stoatworks-labs/stoatworks-parts/bidi-microusb-guard/check_sections.png

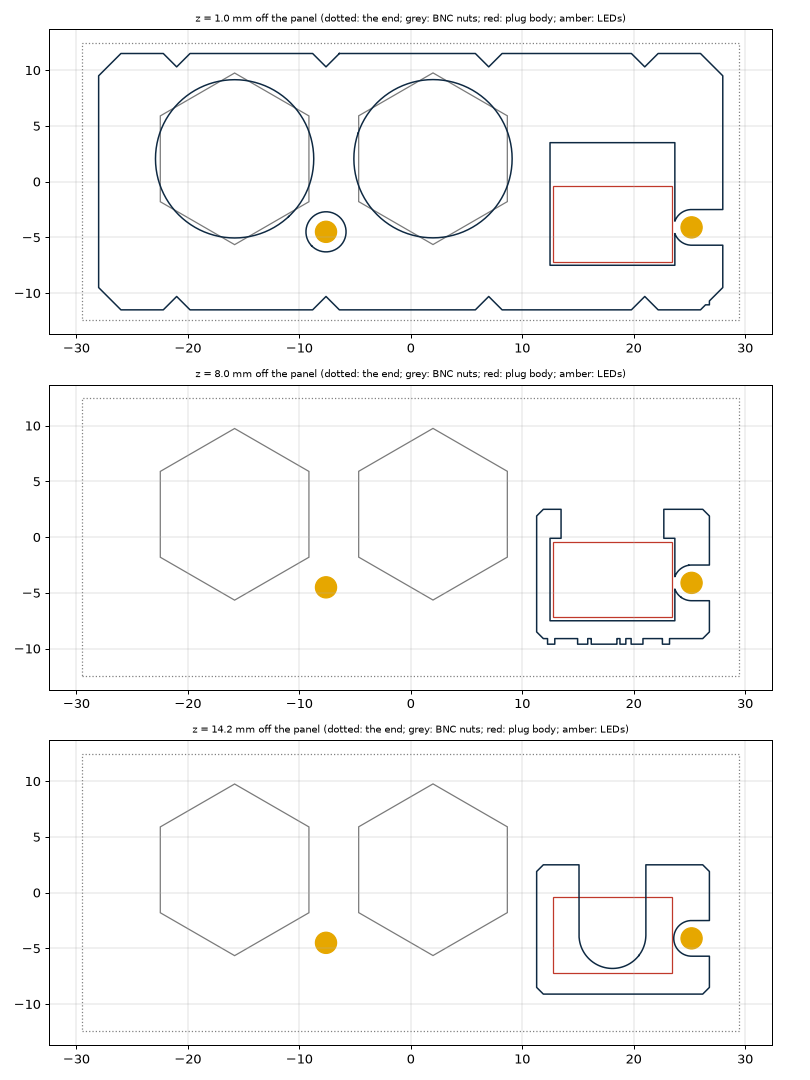
bidi-microusb-guard/check_sections.png
