stoatworks-labs/stoatworks-parts/bidi-usb-guard/check_sections.png

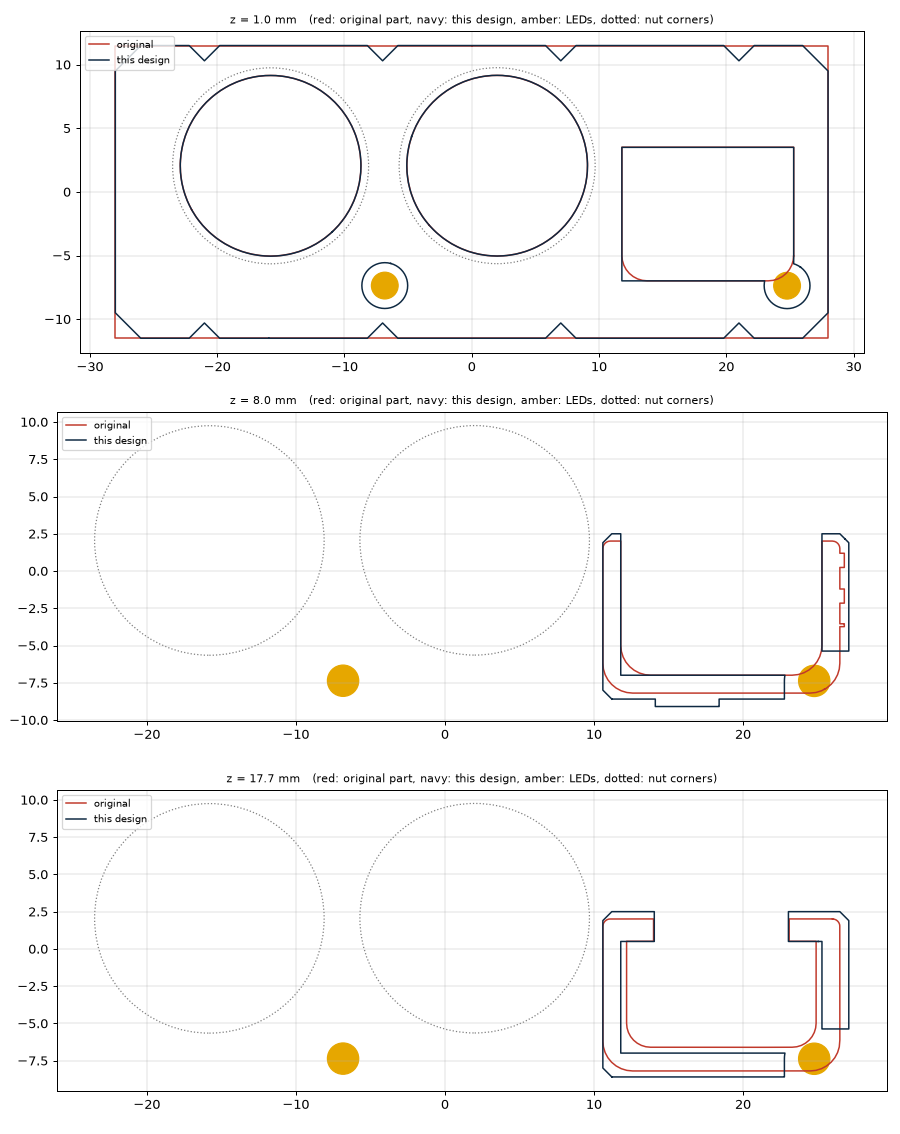
bidi-usb-guard/check_sections.png
