stoatworks-labs/stoatworks-parts/decimator-microusb-guard/check_sections.png

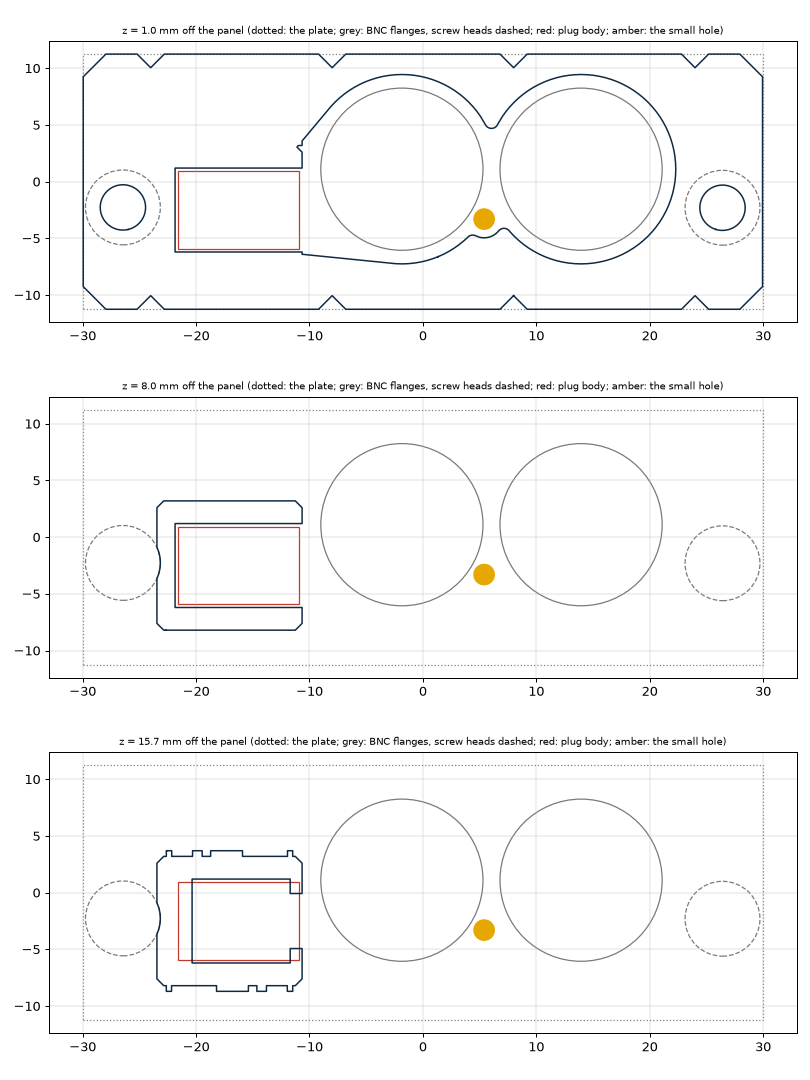
decimator-microusb-guard/check_sections.png
