stoatworks-labs/stoatworks-parts/decimator-usb-guard/check_sections.png

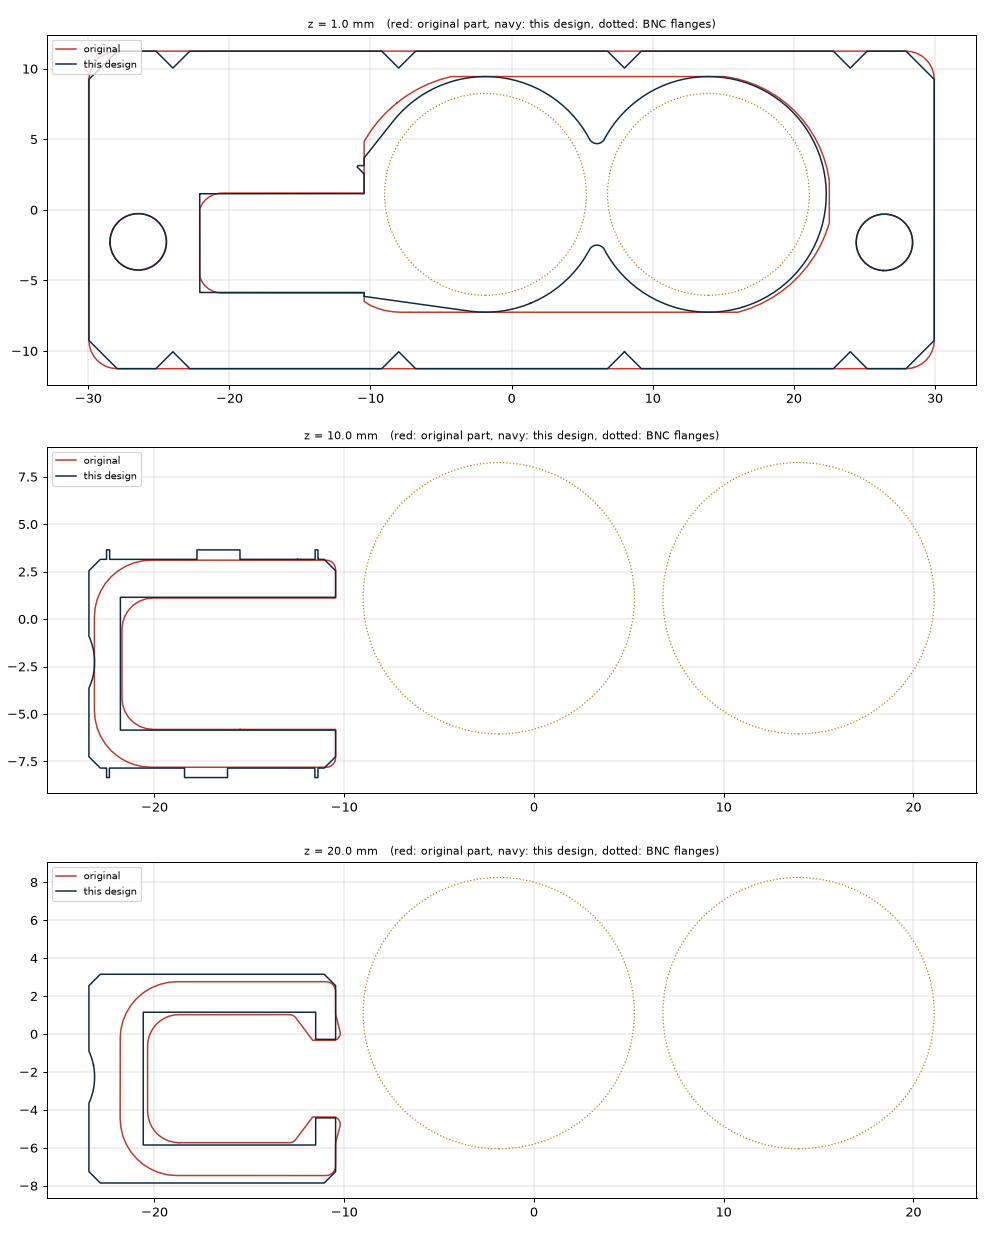
decimator-usb-guard/check_sections.png
