stoatworks-labs/stoatworks-parts/ip-mini-hdmi-clamp/check_sections.png

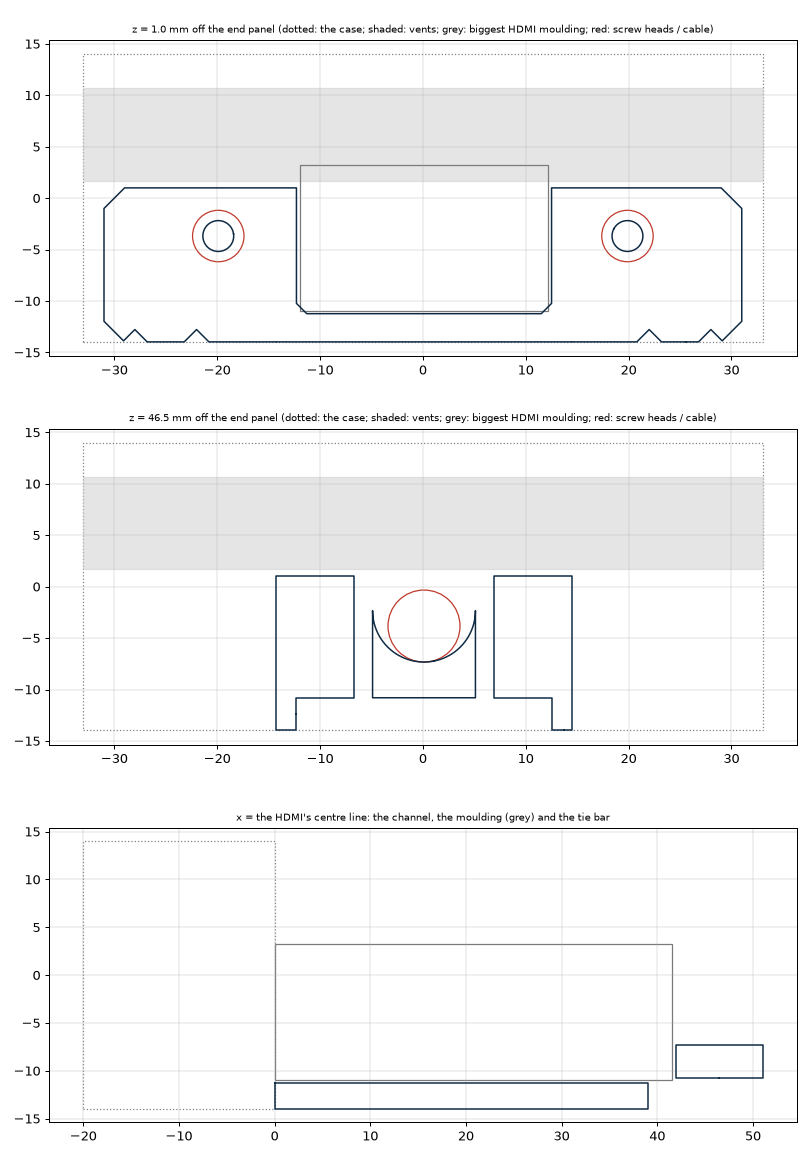
ip-mini-hdmi-clamp/check_sections.png
