stoatworks-labs/stoatworks-parts/micro-converter-microusb/check_sections.png

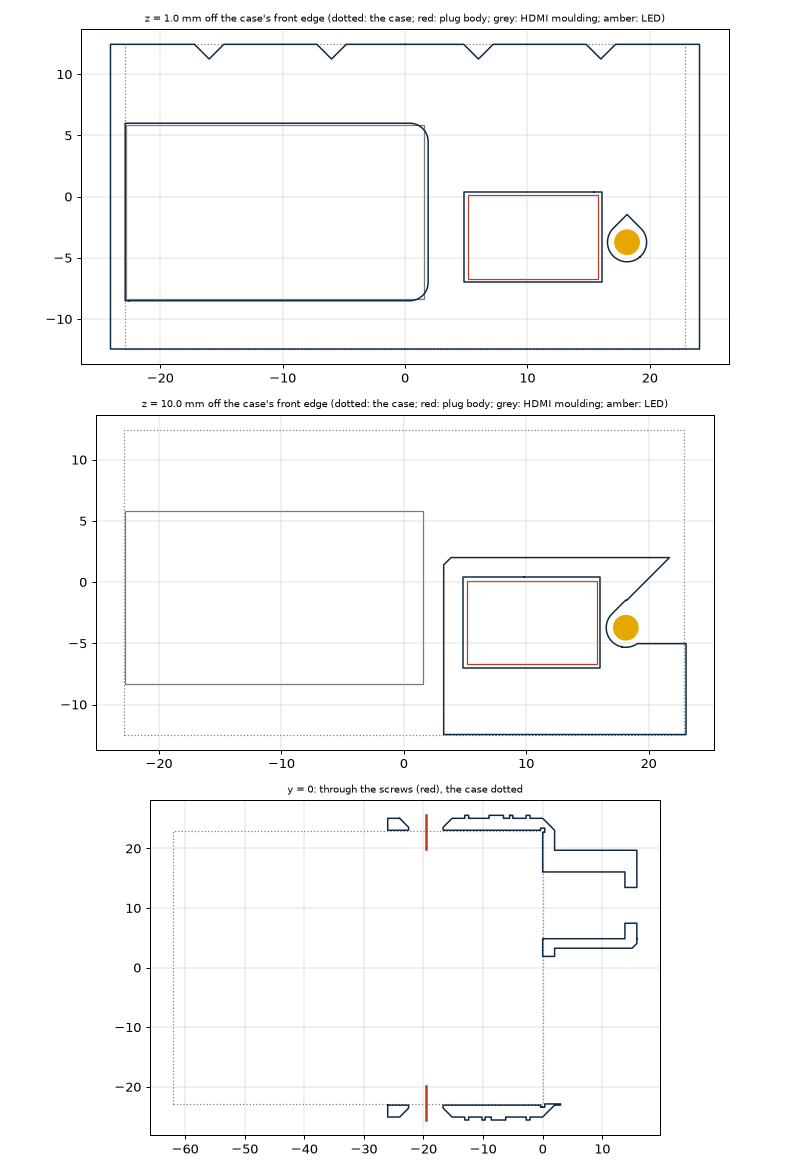
micro-converter-microusb/check_sections.png
