stoatworks-labs/stoatworks-parts/micro-converter-usb-guard/check_sections.png

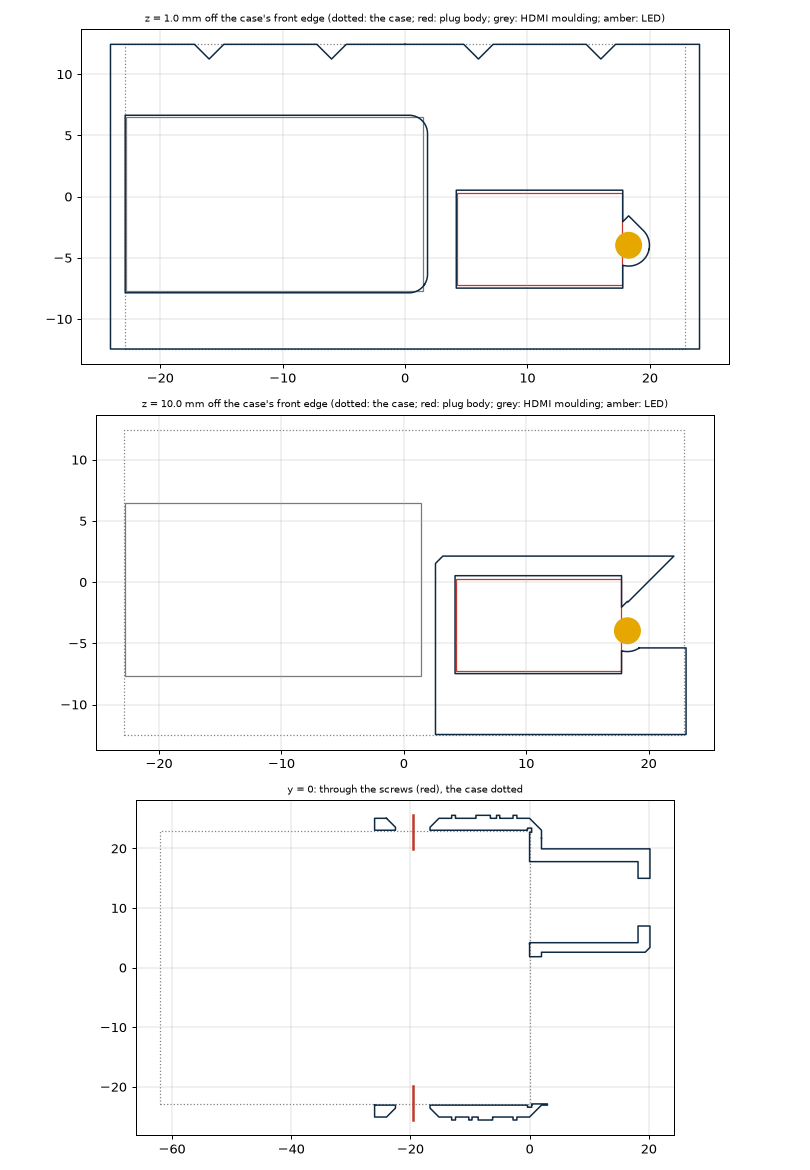
micro-converter-usb-guard/check_sections.png
