stoatworks-labs/stoatworks-parts/mini-converter-power-clamp/check_sections.png

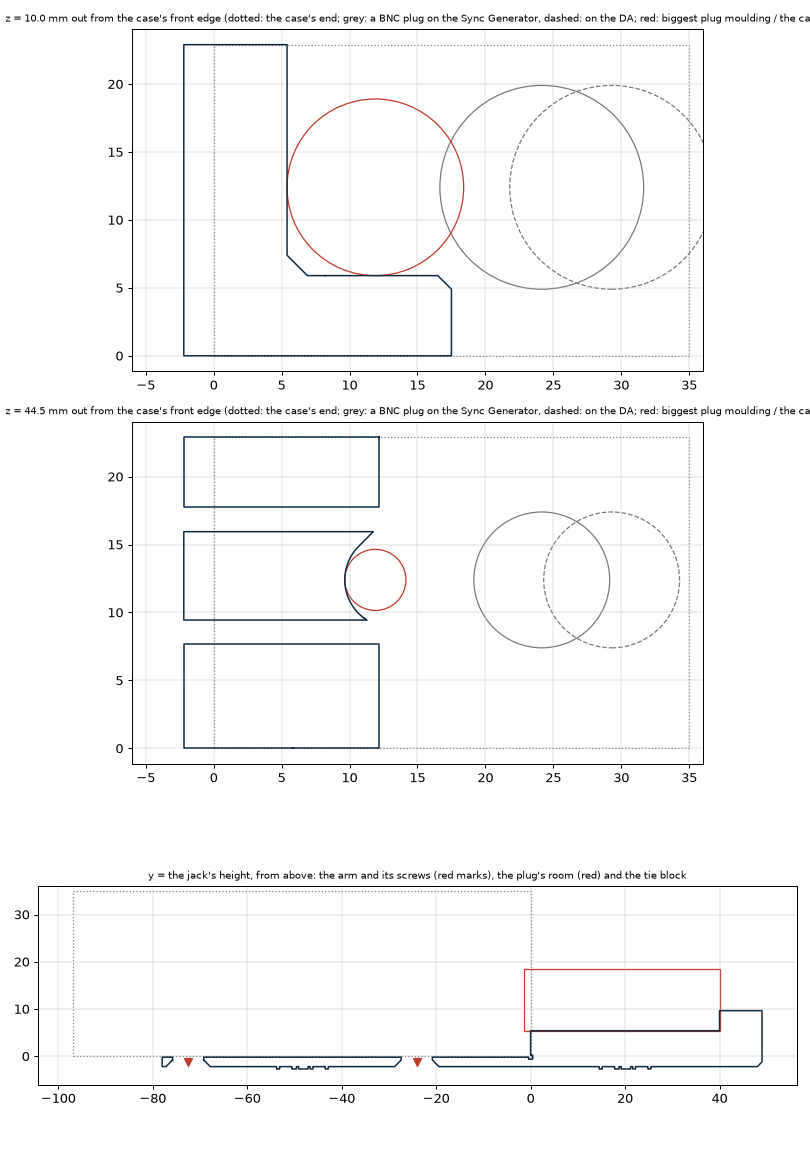
mini-converter-power-clamp/check_sections.png
