stoatworks-labs/stoatworks-parts/mini-converter-power-guard/check_sections.png

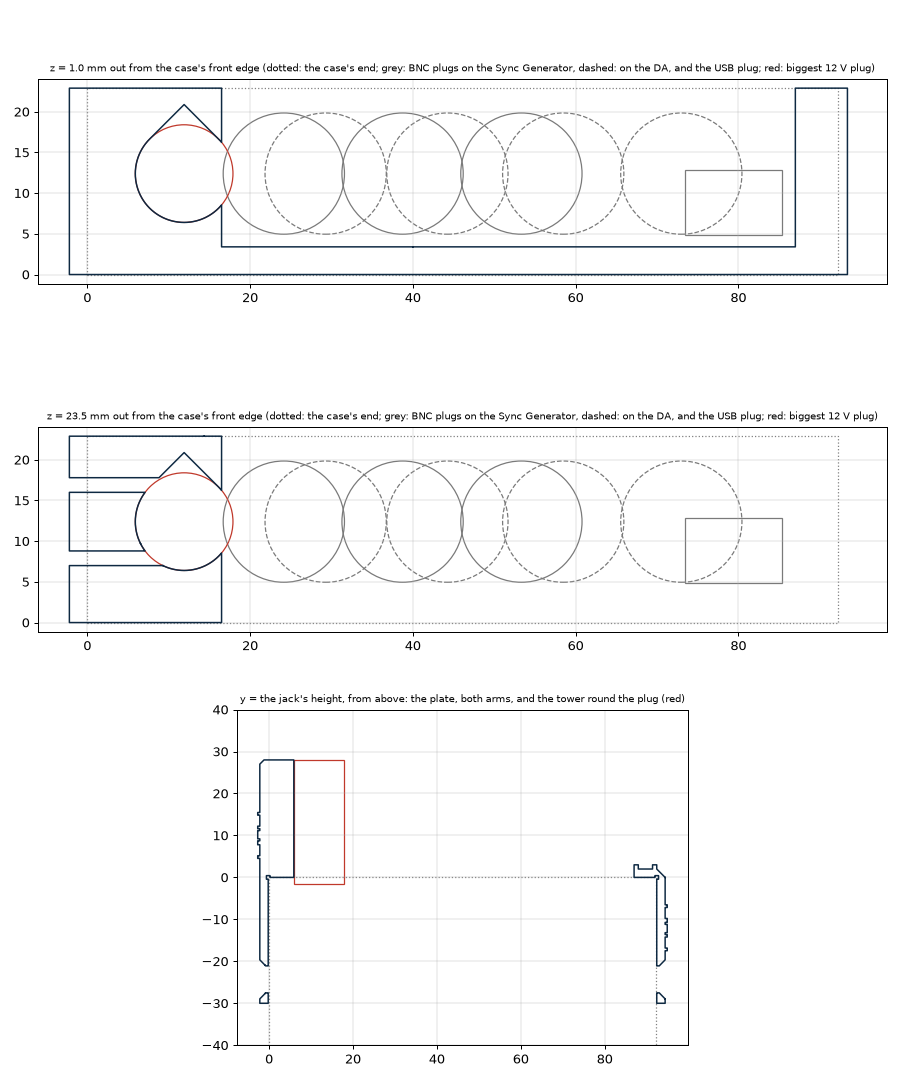
mini-converter-power-guard/check_sections.png
