stoatworks-labs/stoatworks-parts/bidi-microusb-guard/bidi_microusb_guard_v0.1-logo.stl

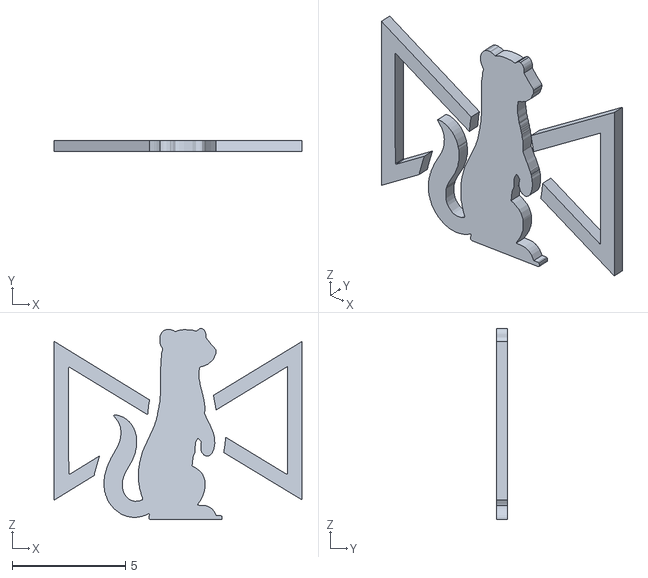
[picture p51: CAD file, 2026-10-25]
bidi-microusb-guard/bidi_microusb_guard_v0.1-logo.stl
10.9 x 0.5 x 8.44
