stoatworks-labs/stoatworks-parts/decimator-microusb-guard/decimator_microusb_guard_v0.1.stl

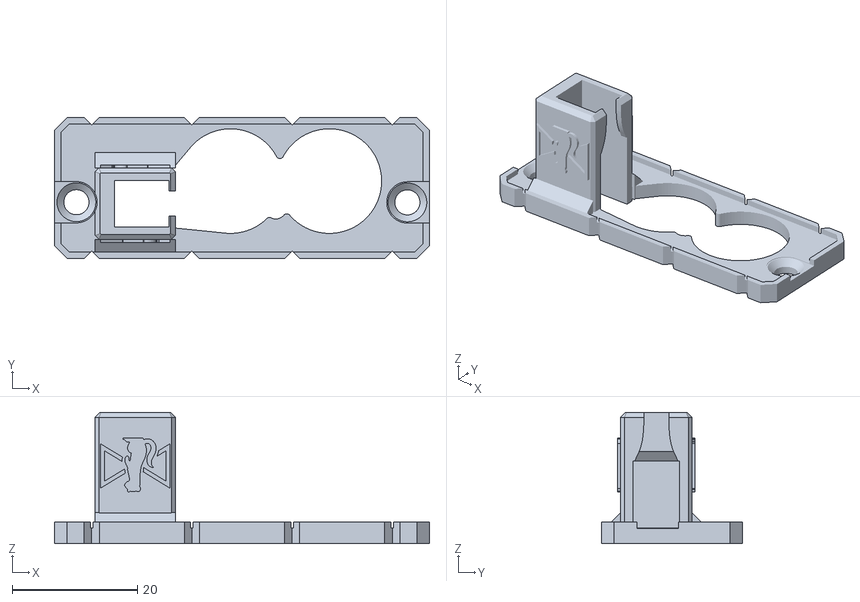
[picture p52: CAD file, 2026-10-25]
decimator-microusb-guard/decimator_microusb_guard_v0.1.stl
59.9 x 22.5 x 21.0
