stoatworks-labs/stoatworks-parts/ip-mini-hdmi-clamp/ip_mini_hdmi_clamp_v0.1.stl

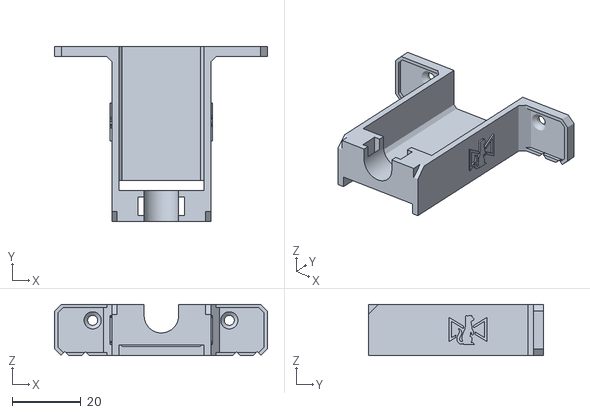
[picture p54: CAD file, 2026-10-25]
ip-mini-hdmi-clamp/ip_mini_hdmi_clamp_v0.1.stl
62.0 x 51.0 x 15.0
