stoatworks-labs/stoatworks-parts/micro-converter-microusb/micro_converter_microusb_guard_v0.1-body.stl

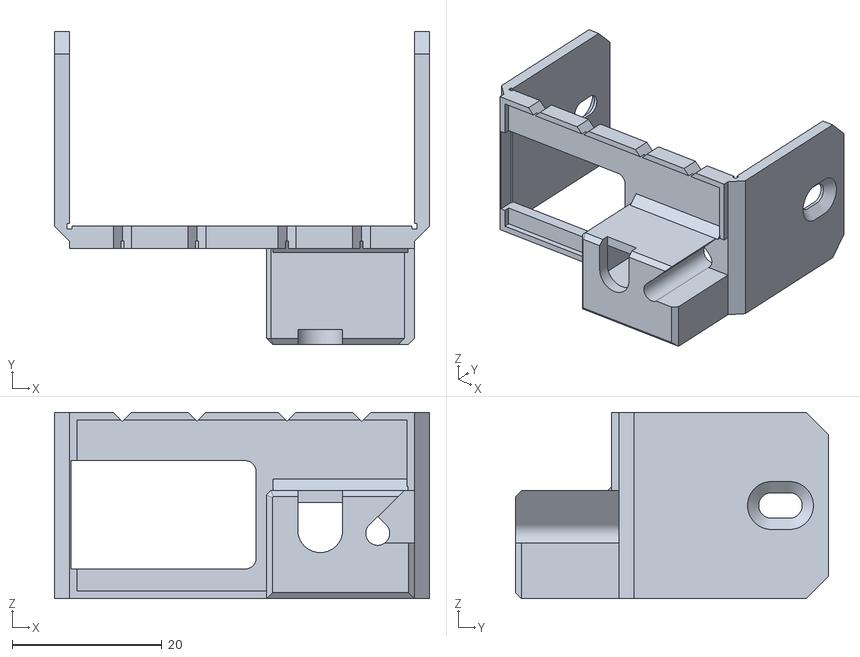
[picture p55: CAD file, 2026-10-25]
micro-converter-microusb/micro_converter_microusb_guard_v0.1-body.stl
50.1 x 41.8 x 24.9
