stoatworks-labs/stoatworks-parts/micro-converter-usb-guard/micro_converter_usb_guard_v0.1-body.stl

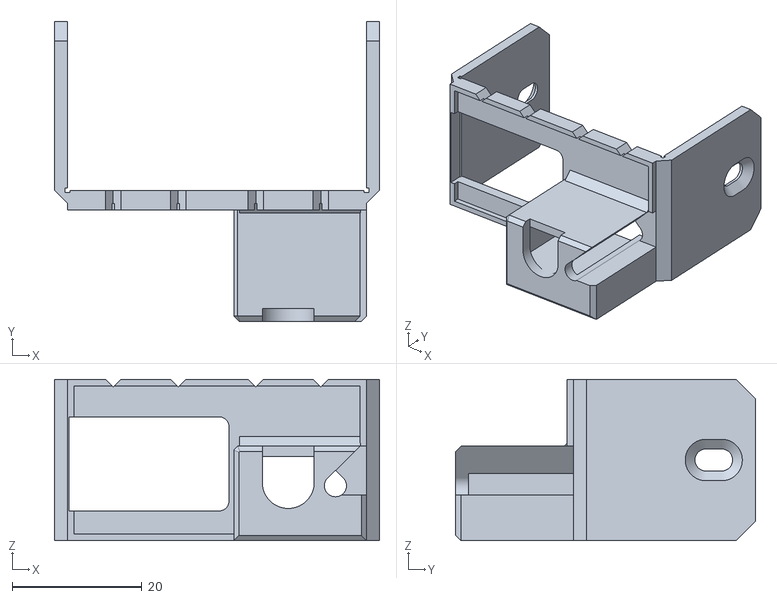
[picture p56: CAD file, 2026-10-25]
micro-converter-usb-guard/micro_converter_usb_guard_v0.1-body.stl
50.1 x 46.2 x 24.9
