stoatworks-labs/stoatworks-parts/mini-converter-power-clamp/mini_converter_power_clamp_v0.1-logo.stl

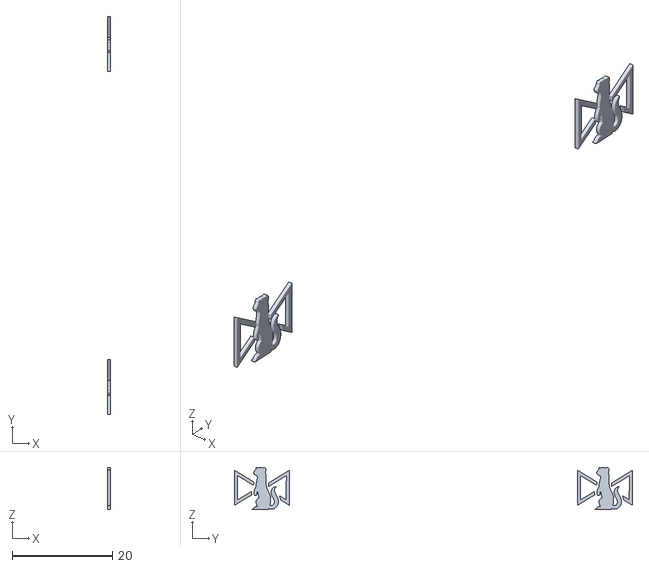
[picture p57: CAD file, 2026-10-25]
mini-converter-power-clamp/mini_converter_power_clamp_v0.1-logo.stl
0.5 x 79.2 x 8.44
