stoatworks-labs/stoatworks-parts/mini-converter-power-guard/mini_converter_power_guard_v0.1.stl

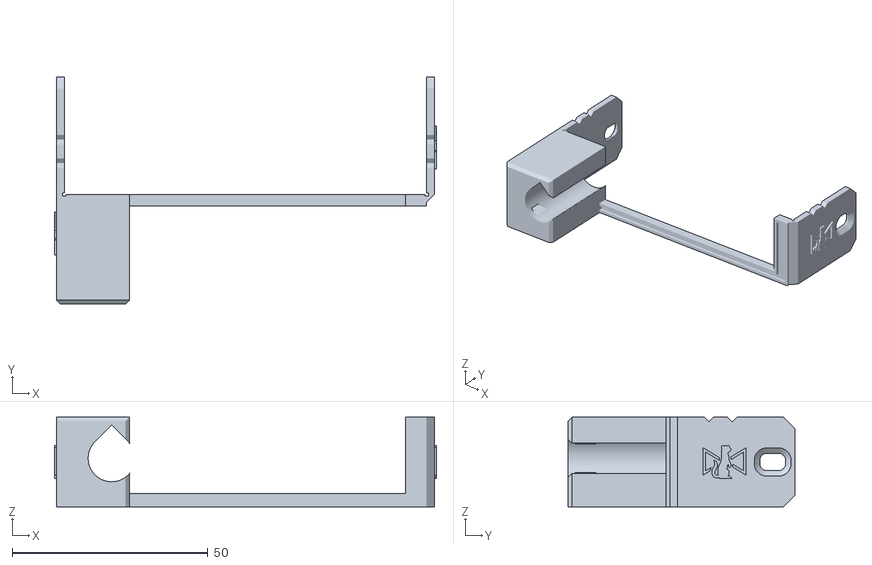
[picture p58: CAD file, 2026-10-25]
mini-converter-power-guard/mini_converter_power_guard_v0.1.stl
97.6 x 58.0 x 22.9
