stoatworks-labs/stoatworks-parts/bidi-usb-guard/bidi_usb_guard_v0.1-body.stl

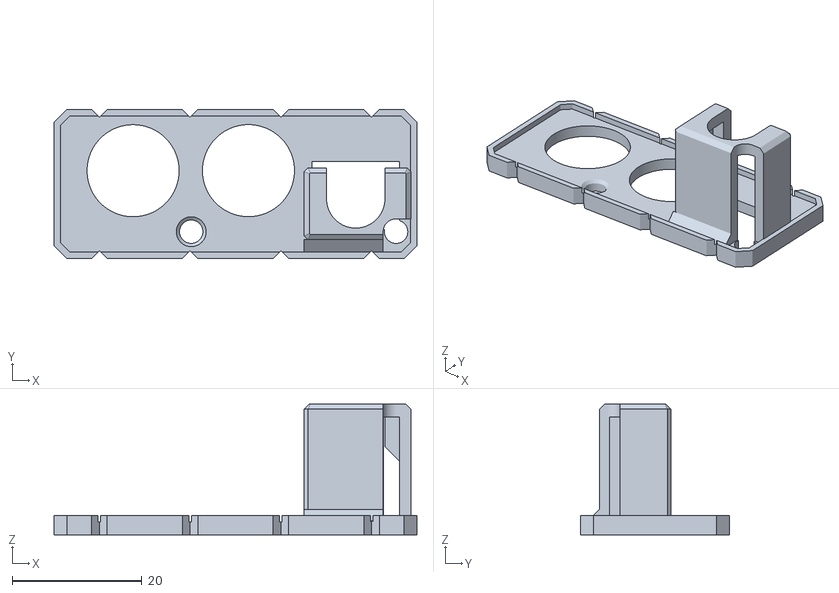
[picture p60: CAD file, 2026-10-25]
bidi-usb-guard/bidi_usb_guard_v0.1-body.stl
56.0 x 23.0 x 20.2
