stoatworks-labs/stoatworks-parts/decimator-microusb-guard/decimator_microusb_guard_v0.1-body.stl

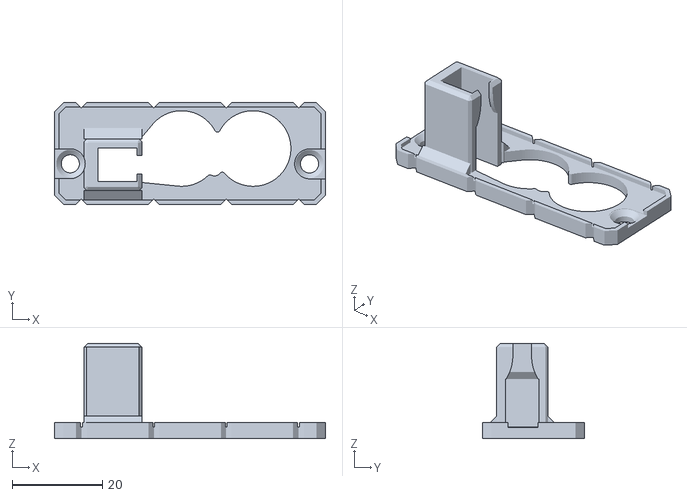
[picture p61: CAD file, 2026-10-25]
decimator-microusb-guard/decimator_microusb_guard_v0.1-body.stl
59.9 x 22.5 x 21.0
