stoatworks-labs/stoatworks-parts/decimator-usb-guard/decimator_usb_guard_v0.1-body.stl

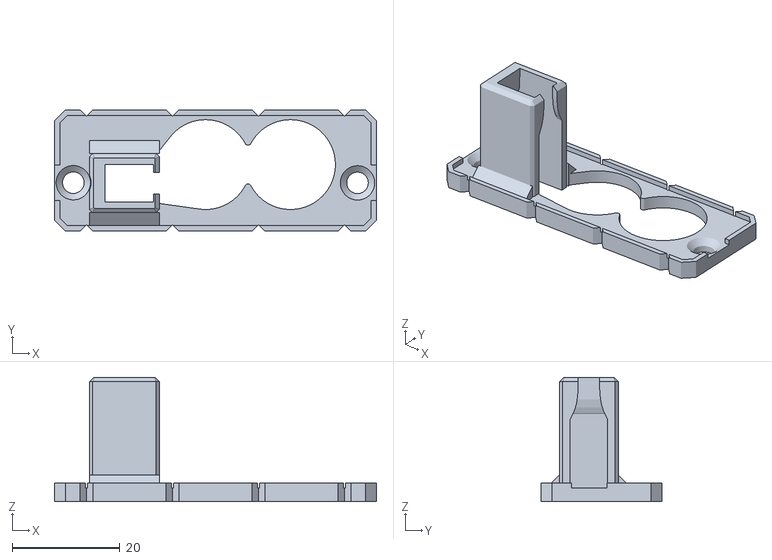
[picture p62: CAD file, 2026-10-25]
decimator-usb-guard/decimator_usb_guard_v0.1-body.stl
59.9 x 22.5 x 23.1
