stoatworks-labs/stoatworks-parts/ip-mini-hdmi-clamp/ip_mini_hdmi_clamp_v0.1-body.stl

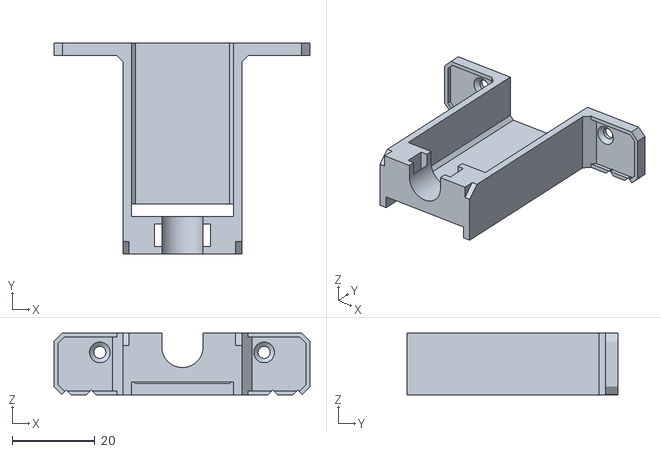
[picture p63: CAD file, 2026-10-25]
ip-mini-hdmi-clamp/ip_mini_hdmi_clamp_v0.1-body.stl
62.0 x 51.0 x 15.0
