stoatworks-labs/stoatworks-parts/micro-converter-microusb/micro_converter_microusb_guard_v0.1.stl

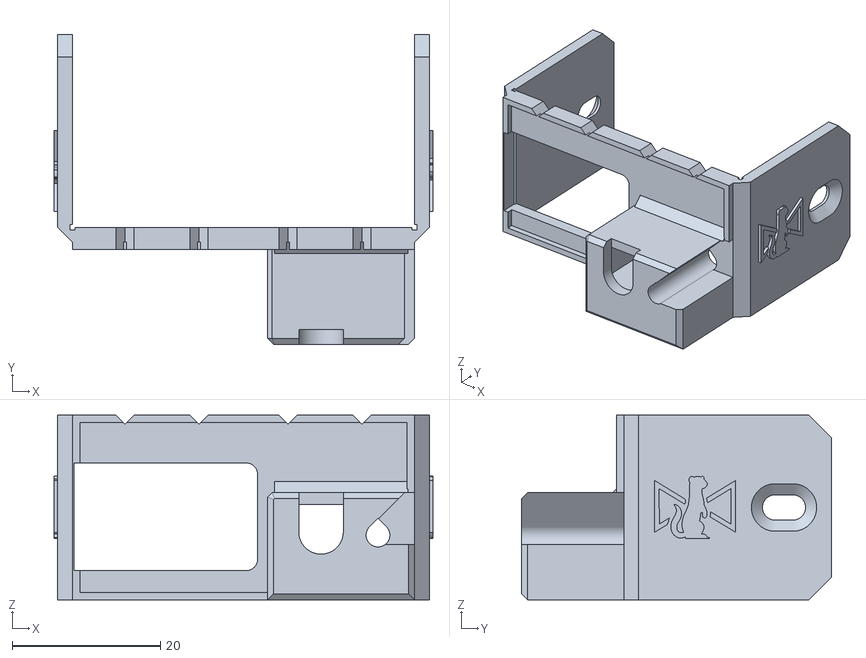
[picture p64: CAD file, 2026-10-25]
micro-converter-microusb/micro_converter_microusb_guard_v0.1.stl
51.1 x 41.8 x 24.9
