stoatworks-labs/stoatworks-parts/micro-converter-usb-guard/micro_converter_usb_guard_v0.1-logo.stl

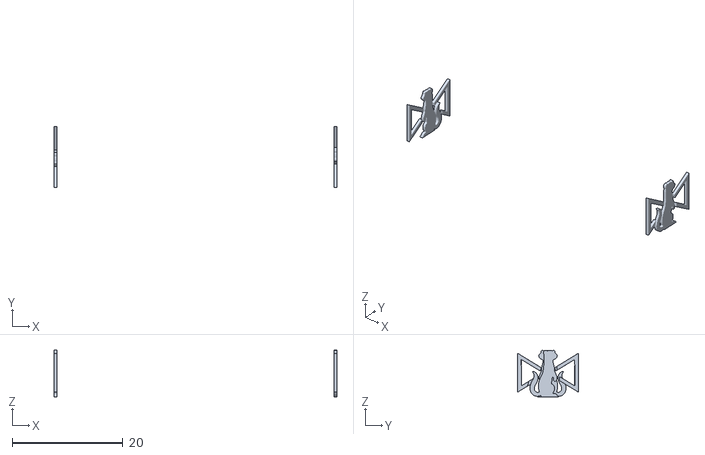
[picture p65: CAD file, 2026-10-25]
micro-converter-usb-guard/micro_converter_usb_guard_v0.1-logo.stl
51.1 x 10.9 x 8.44
