stoatworks-labs/stoatworks-parts/mini-converter-power-clamp/mini_converter_power_clamp_v0.1-body.stl

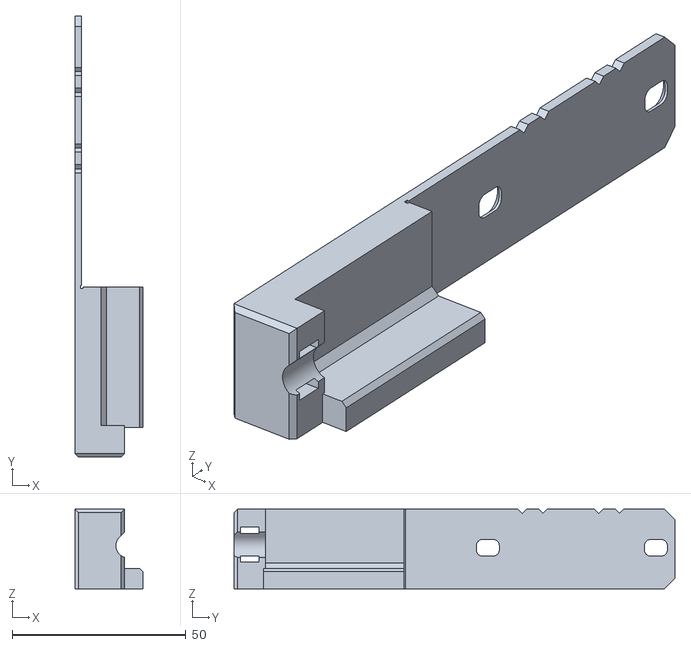
[picture p66: CAD file, 2026-10-25]
mini-converter-power-clamp/mini_converter_power_clamp_v0.1-body.stl
19.7 x 127.0 x 22.9
