stoatworks-labs/stoatworks-parts/mini-converter-power-guard/mini_converter_power_guard_v0.1-logo.stl

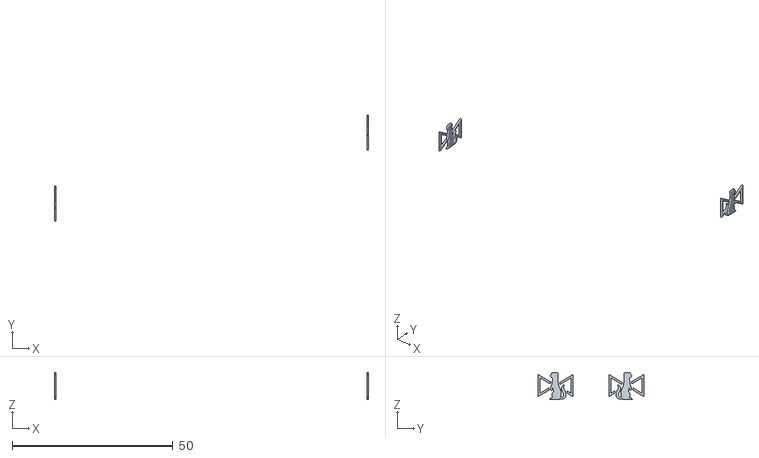
[picture p67: CAD file, 2026-10-25]
mini-converter-power-guard/mini_converter_power_guard_v0.1-logo.stl
97.6 x 32.9 x 8.44
