stoatworks-labs/stoatworks-parts/bidi-microusb-guard/bidi_microusb_guard_v0.1-body.stl

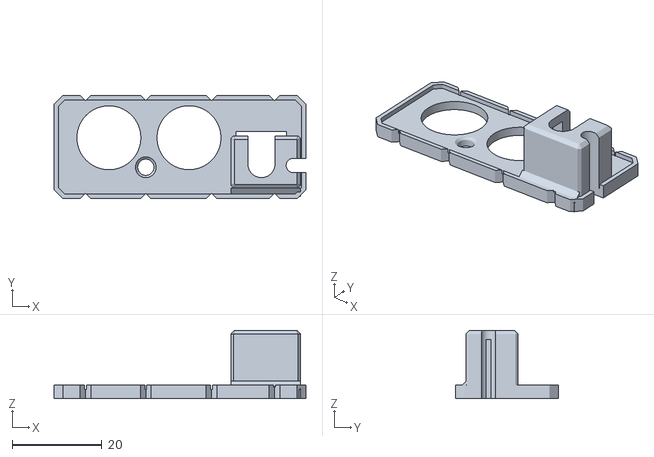
[picture p68: CAD file, 2026-10-25]
bidi-microusb-guard/bidi_microusb_guard_v0.1-body.stl
56.0 x 23.0 x 15.2
