stoatworks-labs/stoatworks-parts/decimator-microusb-guard/decimator_microusb_guard_v0.1-logo.stl

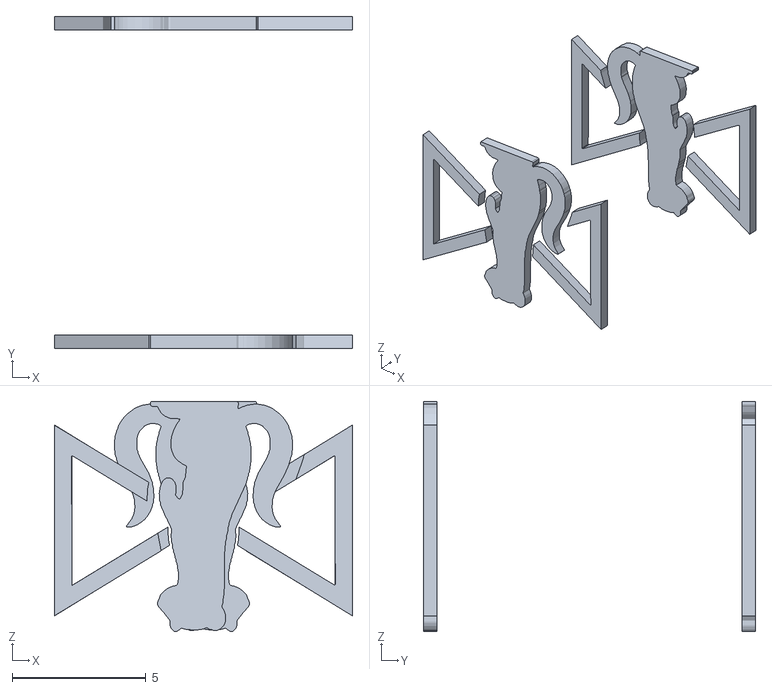
[picture p69: CAD file, 2026-10-25]
decimator-microusb-guard/decimator_microusb_guard_v0.1-logo.stl
11.1 x 12.4 x 8.59
