stoatworks-labs/stoatworks-parts/ip-mini-hdmi-clamp/ip_mini_hdmi_clamp_v0.1-logo.stl

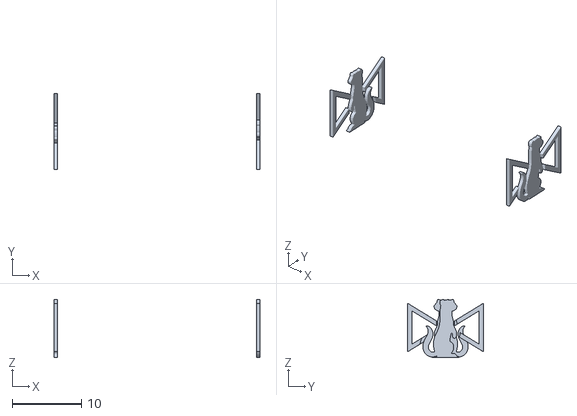
[picture p70: CAD file, 2026-10-25]
ip-mini-hdmi-clamp/ip_mini_hdmi_clamp_v0.1-logo.stl
29.8 x 10.9 x 8.44
