stoatworks-labs/stoatworks-parts/micro-converter-usb-guard/micro_converter_usb_guard_v0.1.stl

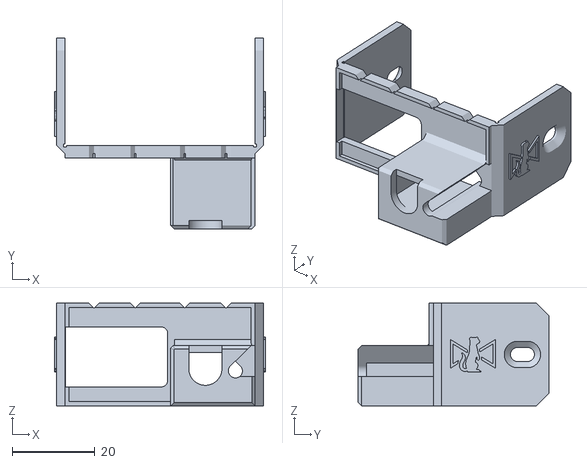
[picture p71: CAD file, 2026-10-25]
micro-converter-usb-guard/micro_converter_usb_guard_v0.1.stl
51.1 x 46.2 x 24.9
