stoatworks-labs/stoatworks-parts/mini-converter-power-clamp/mini_converter_power_clamp_v0.1.stl

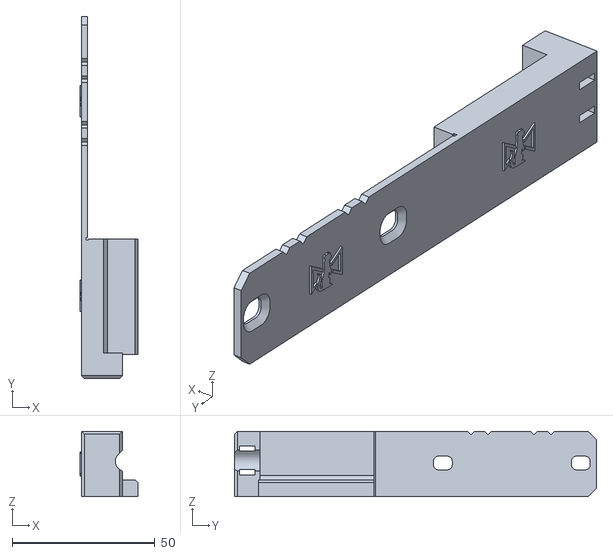
[picture p72: CAD file, 2026-10-25]
mini-converter-power-clamp/mini_converter_power_clamp_v0.1.stl
20.2 x 127.0 x 22.9
