stoatworks-labs/stoatworks-parts/bidi-microusb-guard/stoatworks_mark.scad

// Generated by stoatworks-remixes/logo.py. Do not edit.
// Stoatworks mark, solid, 10.94 x 8.44 mm, centred on the origin.
module stoatworks_mark() polygon(points=[[1.0692,4.2275],[1.1640,4.1434],[1.2142,4.0511],[1.2290,3.9857],[1.2301,3.8238],[1.4651,3.5213],[1.6465,3.3219],[1.6815,3.2540],[1.6670,3.1031],[1.6274,3.0331],[1.5821,2.8935],[1.5365,2.8345],[1.3234,2.6471],[1.1258,2.5612],[1.0247,2.5436],[0.9576,2.5065],[0.9194,2.3050],[0.9208,2.0477],[0.9597,1.8741],[0.9632,1.7737],[1.0028,1.6592],[1.0060,1.5892],[1.0452,1.5044],[1.0625,1.3906],[1.0876,1.3488],[1.1039,1.2244],[1.1300,1.1774],[1.1463,1.0130],[1.1718,0.9395],[1.1877,0.7285],[1.1749,0.4599],[1.3446,0.0912],[1.3973,0.0081],[1.5012,-0.2485],[1.5259,-0.2778],[1.5429,-0.3609],[1.5676,-0.3885],[1.5846,-0.5139],[1.6108,-0.5769],[1.6249,-0.8469],[1.5825,-1.1078],[1.5076,-1.2707],[1.4528,-1.3400],[1.3944,-1.3838],[1.3329,-1.4128],[1.2502,-1.4118],[1.1449,-1.3619],[1.0495,-1.2527],[1.0042,-1.1099],[1.0056,-0.9010],[1.0300,-0.7826],[0.9484,-0.6741],[0.8992,-0.6387],[0.8614,-0.6444],[0.7798,-0.7967],[0.7653,-0.8593],[0.7483,-1.2198],[0.7352,-1.2955],[0.7094,-1.3209],[0.6656,-1.4365],[0.6221,-1.8458],[0.7617,-1.9144],[0.9975,-2.0933],[1.0873,-2.2148],[1.1714,-2.4230],[1.1859,-2.5019],[1.1873,-2.8069],[1.1725,-2.9317],[1.0862,-3.1770],[0.9879,-3.3718],[0.8784,-3.5280],[0.8642,-3.5754],[1.2198,-3.5923],[1.3944,-3.6637],[1.4924,-3.7348],[1.5793,-3.8246],[1.6889,-4.0296],[1.8854,-4.0313],[1.9268,-4.0540],[1.9501,-4.0964],[1.9512,-4.1784],[1.9162,-4.2134],[-1.2170,-4.2105],[-1.2842,-4.1787],[-1.2856,-4.0964],[-1.2584,-4.0045],[-1.2598,-3.9681],[-1.2806,-3.9433],[-1.4471,-4.0274],[-1.4938,-4.0317],[-1.5786,-4.0709],[-1.8504,-4.1140],[-1.9992,-4.1126],[-2.2530,-4.0709],[-2.5075,-3.9719],[-2.7963,-3.7567],[-2.9607,-3.5771],[-3.0490,-3.4463],[-3.1081,-3.3449],[-3.1544,-3.2021],[-3.1943,-3.1303],[-3.1964,-3.0766],[-3.2360,-2.9769],[-3.2643,-2.7465],[-3.2650,-2.5093],[-3.2360,-2.2406],[-3.1964,-2.1406],[-3.1798,-2.0427],[-3.1551,-2.0028],[-3.1367,-1.8996],[-2.9667,-1.5189],[-2.6606,-0.9713],[-2.5888,-0.7992],[-2.5326,-0.6002],[-2.5171,-0.3202],[-2.5471,-0.1039],[-2.6316,0.0915],[-2.8398,0.3750],[-2.8214,0.3959],[-2.6726,0.3948],[-2.6065,0.3796],[-2.4220,0.3086],[-2.2661,0.2061],[-2.1526,0.1096],[-2.0551,-0.0049],[-1.9526,-0.1760],[-1.8674,-0.3902],[-1.8653,-0.4440],[-1.8391,-0.5040],[-1.8239,-0.6698],[-1.8257,-0.9752],[-1.8653,-1.1414],[-1.8674,-1.2198],[-2.0102,-1.5917],[-2.3022,-2.0986],[-2.4015,-2.3241],[-2.4047,-2.3810],[-2.4308,-2.4262],[-2.4442,-2.5019],[-2.4442,-2.8426],[-2.4015,-3.0066],[-2.3442,-3.1176],[-2.1724,-3.3060],[-2.0717,-3.3633],[-1.9151,-3.4057],[-1.7051,-3.3923],[-1.5744,-3.3343],[-1.5546,-3.2873],[-1.6390,-3.0596],[-1.6412,-3.0059],[-1.6949,-2.8355],[-1.6977,-2.7401],[-1.7232,-2.6790],[-1.7373,-2.5266],[-1.7373,-1.9978],[-1.6815,-1.6203],[-1.6553,-1.5751],[-1.6387,-1.4637],[-1.6129,-1.4195],[-1.6108,-1.3658],[-1.5531,-1.1785],[-1.0343,-0.0516],[-1.0166,0.0357],[-0.9484,0.2064],[-0.9321,0.3308],[-0.9059,0.3909],[-0.8897,0.5553],[-0.8501,0.6992],[-0.8466,0.7996],[-0.8077,0.9413],[-0.7653,1.4683],[-0.7607,2.8002],[-0.7221,3.0246],[-0.7193,3.1455],[-0.6787,3.2915],[-0.6787,3.3315],[-0.7610,3.4683],[-0.8041,3.6022],[-0.8049,3.8521],[-0.7904,3.9097],[-0.7317,4.0218],[-0.6292,4.1278],[-0.5009,4.1833],[-0.3475,4.1833],[-0.3061,4.1589],[-0.2213,4.1416],[-0.1202,4.0844],[0.0368,4.1416],[0.2633,4.1706],[0.6288,4.1550],[0.8034,4.1003],[0.9809,4.2275],[-1.2920,0.8632],[-1.3397,0.4150],[-4.8065,2.5245],[-4.8355,2.4959],[-4.8196,-2.2039],[-4.7715,-2.2060],[-3.4624,-1.4006],[-3.6744,-2.1390],[-3.6974,-2.2651],[-5.4717,-3.3561],[-5.4724,3.6587],[-1.2515,1.0679],[5.4717,-3.3421],[2.0128,-1.2488],[2.0562,-1.0279],[2.1040,-0.5773],[4.7856,-2.2060],[4.8337,-2.2039],[4.8316,2.5429],[1.6833,0.6268],[1.5620,1.2707],[5.4717,3.6501]],
    paths=[[0, 1, 2, 3, 4, 5, 6, 7, 8, 9, 10, 11, 12, 13, 14, 15, 16, 17, 18, 19, 20, 21, 22, 23, 24, 25, 26, 27, 28, 29, 30, 31, 32, 33, 34, 35, 36, 37, 38, 39, 40, 41, 42, 43, 44, 45, 46, 47, 48, 49, 50, 51, 52, 53, 54, 55, 56, 57, 58, 59, 60, 61, 62, 63, 64, 65, 66, 67, 68, 69, 70, 71, 72, 73, 74, 75, 76, 77, 78, 79, 80, 81, 82, 83, 84, 85, 86, 87, 88, 89, 90, 91, 92, 93, 94, 95, 96, 97, 98, 99, 100, 101, 102, 103, 104, 105, 106, 107, 108, 109, 110, 111, 112, 113, 114, 115, 116, 117, 118, 119, 120, 121, 122, 123, 124, 125, 126, 127, 128, 129, 130, 131, 132, 133, 134, 135, 136, 137, 138, 139, 140, 141, 142, 143, 144, 145, 146, 147, 148, 149, 150, 151, 152, 153, 154, 155, 156, 157, 158, 159, 160, 161, 162, 163, 164, 165, 166, 167, 168, 169, 170, 171, 172, 173, 174, 175, 176, 177, 178, 179, 180, 181, 182, 183, 184, 185, 186, 187, 188, 189, 190, 191], [192, 193, 194, 195, 196, 197, 198, 199, 200, 201, 202, 203], [204, 205, 206, 207, 208, 209, 210, 211, 212, 213]]);
