stoatworks-labs/stoatworks-parts/decimator-microusb-guard/stoatworks_mark.scad

// Generated by stoatworks-remixes/logo.py. Do not edit.
// Stoatworks mark, solid, 11.14 x 8.59 mm, centred on the origin.
module stoatworks_mark() polygon(points=[[1.0887,4.3044],[1.1851,4.2187],[1.2362,4.1248],[1.2514,4.0582],[1.2524,3.8934],[1.4918,3.5853],[1.6764,3.3823],[1.7120,3.3132],[1.7120,3.2081],[1.6973,3.1595],[1.6570,3.0883],[1.6109,2.9461],[1.5645,2.8860],[1.4763,2.7950],[1.3475,2.6953],[1.1463,2.6078],[1.0433,2.5898],[0.9750,2.5520],[0.9361,2.3469],[0.9375,2.0849],[0.9771,1.9082],[0.9807,1.8060],[1.0210,1.6894],[1.0243,1.6181],[1.0642,1.5317],[1.0819,1.4158],[1.1074,1.3734],[1.1240,1.2467],[1.1506,1.1988],[1.1671,1.0315],[1.1931,0.9566],[1.2093,0.7417],[1.1963,0.4682],[1.3690,0.0929],[1.4227,0.0083],[1.5285,-0.2530],[1.5537,-0.2829],[1.5710,-0.3675],[1.5961,-0.3955],[1.6134,-0.5233],[1.6401,-0.5874],[1.6544,-0.8623],[1.6113,-1.1279],[1.5350,-1.2938],[1.4792,-1.3644],[1.4198,-1.4090],[1.3572,-1.4385],[1.2730,-1.4374],[1.1657,-1.3867],[1.0685,-1.2755],[1.0225,-1.1301],[1.0239,-0.9174],[1.0487,-0.7968],[0.9656,-0.6863],[0.9156,-0.6503],[0.8771,-0.6561],[0.7939,-0.8112],[0.7792,-0.8749],[0.7619,-1.2420],[0.7486,-1.3190],[0.7223,-1.3449],[0.6777,-1.4626],[0.6334,-1.8794],[0.7756,-1.9492],[0.9591,-2.0759],[1.0156,-2.1313],[1.1070,-2.2551],[1.1927,-2.4671],[1.2075,-2.5474],[1.2089,-2.8579],[1.1938,-2.9850],[1.1060,-3.2348],[1.0059,-3.4331],[0.8943,-3.5921],[0.8799,-3.6404],[1.2420,-3.6576],[1.4198,-3.7303],[1.5195,-3.8027],[1.6080,-3.8941],[1.7196,-4.1028],[1.9197,-4.1046],[1.9618,-4.1277],[1.9856,-4.1708],[1.9866,-4.2543],[1.9510,-4.2900],[-1.2391,-4.2871],[-1.3075,-4.2547],[-1.3089,-4.1708],[-1.2812,-4.0773],[-1.2827,-4.0402],[-1.3039,-4.0150],[-1.4734,-4.1007],[-1.5209,-4.1050],[-1.6073,-4.1449],[-1.8841,-4.1888],[-2.0356,-4.1874],[-2.2940,-4.1449],[-2.5531,-4.0442],[-2.8471,-3.8250],[-3.0145,-3.6422],[-3.1045,-3.5090],[-3.1646,-3.4057],[-3.2117,-3.2603],[-3.2524,-3.1872],[-3.2546,-3.1325],[-3.2949,-3.0311],[-3.3237,-2.7964],[-3.3244,-2.5549],[-3.2949,-2.2814],[-3.2546,-2.1795],[-3.2376,-2.0798],[-3.2124,-2.0392],[-3.1937,-1.9341],[-3.0206,-1.5465],[-2.7089,-0.9890],[-2.6359,-0.8137],[-2.5787,-0.6111],[-2.5628,-0.3261],[-2.5934,-0.1058],[-2.6794,0.0932],[-2.8914,0.3819],[-2.8727,0.4031],[-2.7212,0.4020],[-2.6539,0.3865],[-2.4660,0.3142],[-2.3073,0.2098],[-2.1918,0.1116],[-2.0924,-0.0050],[-1.9881,-0.1792],[-1.9013,-0.3973],[-1.8992,-0.4520],[-1.8725,-0.5132],[-1.8571,-0.6820],[-1.8589,-0.9930],[-1.8992,-1.1621],[-1.9013,-1.2420],[-2.0467,-1.6206],[-2.3440,-2.1367],[-2.4451,-2.3663],[-2.4484,-2.4243],[-2.4750,-2.4703],[-2.4887,-2.5474],[-2.4887,-2.8943],[-2.4451,-3.0613],[-2.3868,-3.1743],[-2.2119,-3.3661],[-2.1094,-3.4244],[-1.9499,-3.4676],[-1.7361,-3.4539],[-1.6030,-3.3949],[-1.5828,-3.3470],[-1.6688,-3.1153],[-1.6710,-3.0606],[-1.7257,-2.8871],[-1.7286,-2.7899],[-1.7545,-2.7277],[-1.7689,-2.5725],[-1.7689,-2.0341],[-1.7120,-1.6498],[-1.6854,-1.6037],[-1.6685,-1.4903],[-1.6422,-1.4453],[-1.6401,-1.3906],[-1.5814,-1.1999],[-1.0531,-0.0525],[-1.0351,0.0363],[-0.9656,0.2102],[-0.9490,0.3369],[-0.9224,0.3980],[-0.9059,0.5654],[-0.8656,0.7119],[-0.8620,0.8141],[-0.8224,0.9584],[-0.7792,1.4950],[-0.7745,2.8511],[-0.7353,3.0796],[-0.7324,3.2027],[-0.6910,3.3514],[-0.6910,3.3920],[-0.7749,3.5313],[-0.8188,3.6677],[-0.8195,3.9222],[-0.8047,3.9808],[-0.7450,4.0949],[-0.6406,4.2029],[-0.5100,4.2594],[-0.3538,4.2594],[-0.3117,4.2346],[-0.2253,4.2169],[-0.1224,4.1586],[0.0374,4.2169],[0.2681,4.2464],[0.6403,4.2306],[0.8180,4.1748],[0.9987,4.3044],[-1.3074,0.8777],[-1.3343,0.4044],[-4.8939,2.5704],[-4.9234,2.5412],[-4.9072,-2.2440],[-4.8583,-2.2461],[-3.4529,-1.3815],[-3.7216,-2.1386],[-3.7552,-2.3005],[-5.5712,-3.4171],[-5.5719,3.7252],[-1.2668,1.0827],[5.5712,-3.4029],[2.0419,-1.2670],[2.0883,-1.0221],[2.1121,-0.5695],[4.8726,-2.2461],[4.9216,-2.2440],[4.9194,2.5891],[1.7064,0.6336],[1.5830,1.2893],[5.5712,3.7164]],
    paths=[[0, 1, 2, 3, 4, 5, 6, 7, 8, 9, 10, 11, 12, 13, 14, 15, 16, 17, 18, 19, 20, 21, 22, 23, 24, 25, 26, 27, 28, 29, 30, 31, 32, 33, 34, 35, 36, 37, 38, 39, 40, 41, 42, 43, 44, 45, 46, 47, 48, 49, 50, 51, 52, 53, 54, 55, 56, 57, 58, 59, 60, 61, 62, 63, 64, 65, 66, 67, 68, 69, 70, 71, 72, 73, 74, 75, 76, 77, 78, 79, 80, 81, 82, 83, 84, 85, 86, 87, 88, 89, 90, 91, 92, 93, 94, 95, 96, 97, 98, 99, 100, 101, 102, 103, 104, 105, 106, 107, 108, 109, 110, 111, 112, 113, 114, 115, 116, 117, 118, 119, 120, 121, 122, 123, 124, 125, 126, 127, 128, 129, 130, 131, 132, 133, 134, 135, 136, 137, 138, 139, 140, 141, 142, 143, 144, 145, 146, 147, 148, 149, 150, 151, 152, 153, 154, 155, 156, 157, 158, 159, 160, 161, 162, 163, 164, 165, 166, 167, 168, 169, 170, 171, 172, 173, 174, 175, 176, 177, 178, 179, 180, 181, 182, 183, 184, 185, 186, 187, 188, 189, 190, 191, 192, 193, 194], [195, 196, 197, 198, 199, 200, 201, 202, 203, 204, 205, 206], [207, 208, 209, 210, 211, 212, 213, 214, 215, 216]]);
