stoatworks-labs/stoatworks-parts/(list of files, cad)

Other CAD files:
bidi-usb-guard/bidi_usb_guard_v0.1-logo.stl
bidi-usb-guard/bidi_usb_guard_v0.1.stl
decimator-usb-guard/decimator_usb_guard_v0.1-logo.stl
bidi-usb-guard/bidi_usb_guard.scad
bidi-usb-guard/preview.scad
decimator-usb-guard/decimator_usb_guard.scad
decimator-usb-guard/preview.scad
micro-converter-usb-guard/micro_converter_usb_guard.scad
micro-converter-usb-guard/preview.scad
